Lyczko0/par6-mobile-platform/mobile_base/renders/01_hero.png

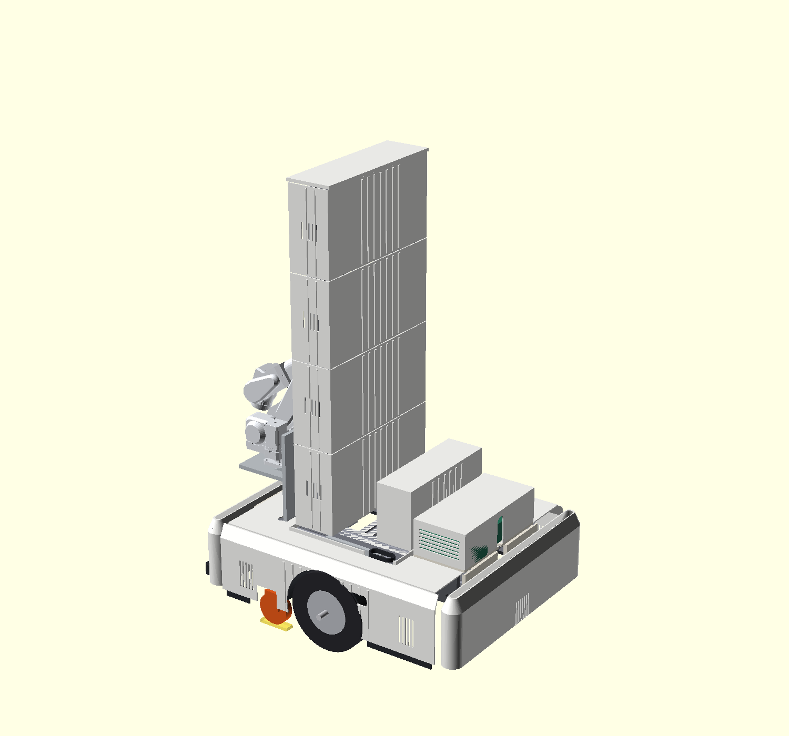
mobile_base/renders/01_hero.png
