Lyczko0/par6-mobile-platform/mobile_base/renders/02_top_bez_oslon.png

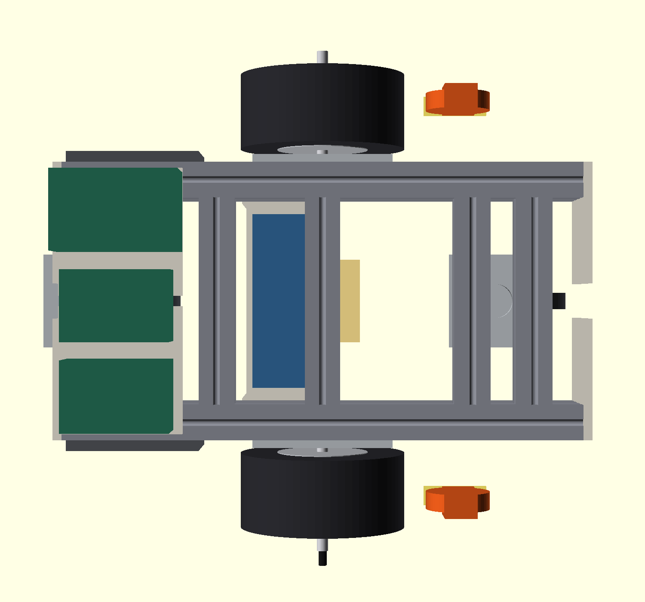
mobile_base/renders/02_top_bez_oslon.png
