Lyczko0/par6-mobile-platform/mobile_base/renders/03_top_z_oslonami.png

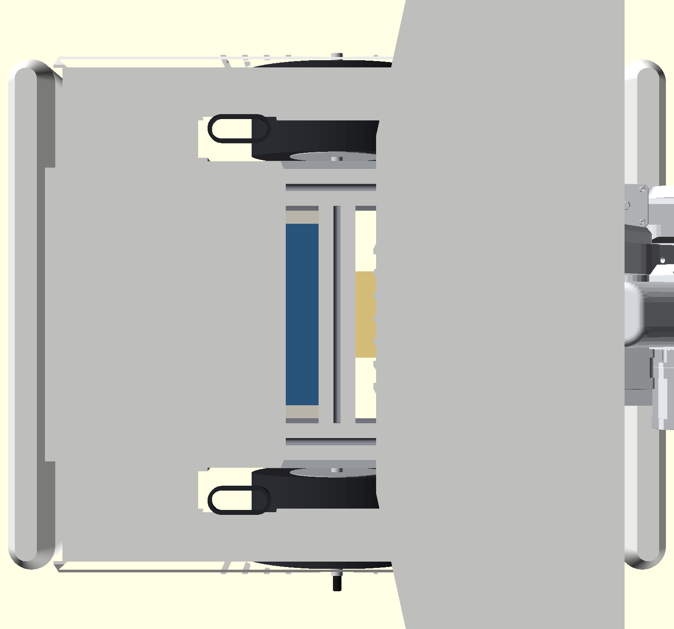
mobile_base/renders/03_top_z_oslonami.png
