Lyczko0/par6-mobile-platform/mobile_base/renders/04_bok_lewy.png

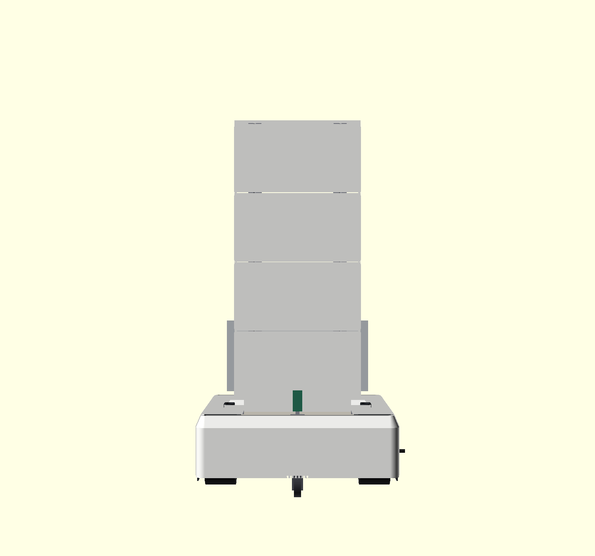
mobile_base/renders/04_bok_lewy.png
