Lyczko0/par6-mobile-platform/mobile_base/renders/06_tyl_serwis.png

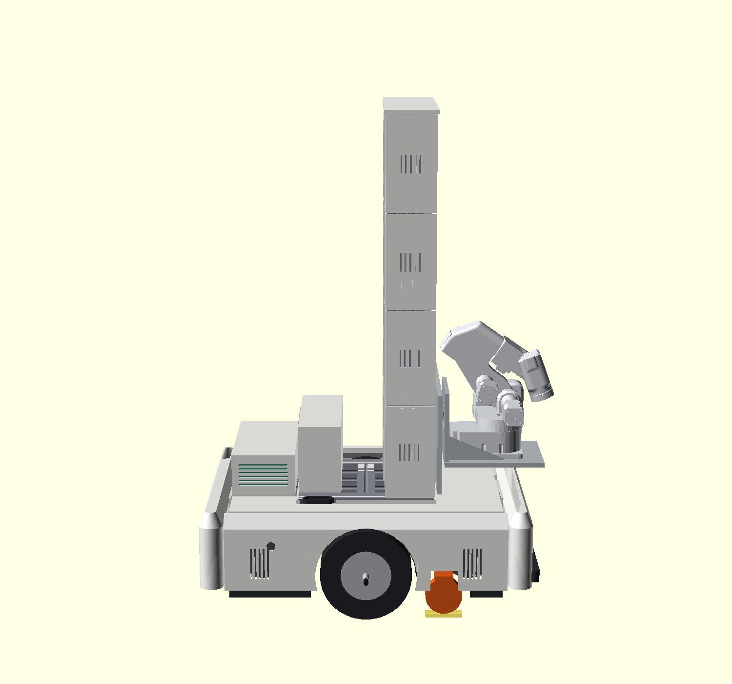
mobile_base/renders/06_tyl_serwis.png
