Lyczko0/par6-mobile-platform/mobile_base/renders/07_spod.png

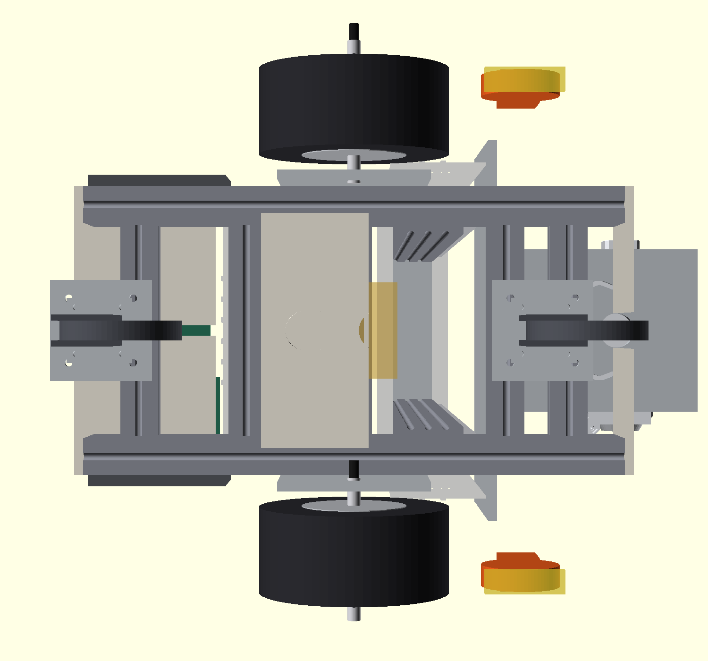
mobile_base/renders/07_spod.png
