Lyczko0/par6-mobile-platform/mobile_base/renders/08_exploded.png

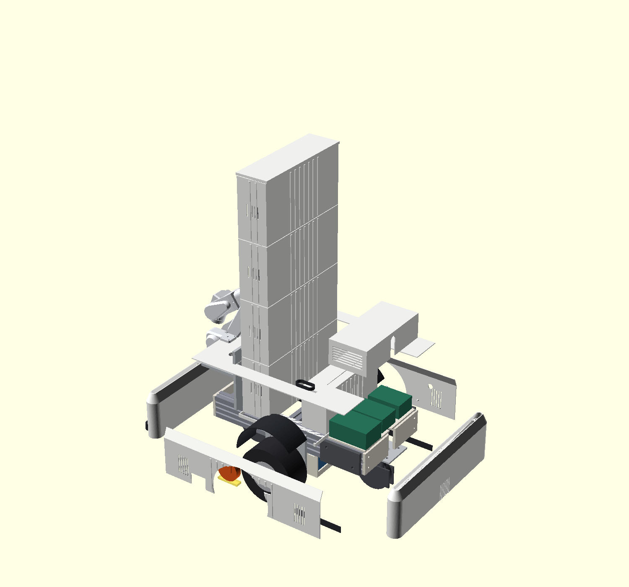
mobile_base/renders/08_exploded.png
