Lyczko0/par6-mobile-platform/mobile_base/renders/13_keepouts.png

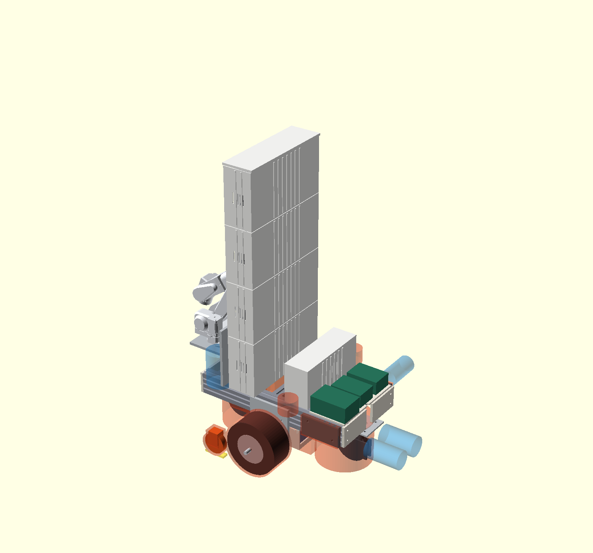
mobile_base/renders/13_keepouts.png
