Lyczko0/par6-mobile-platform/mobile_base/renders/14_par6_real.png

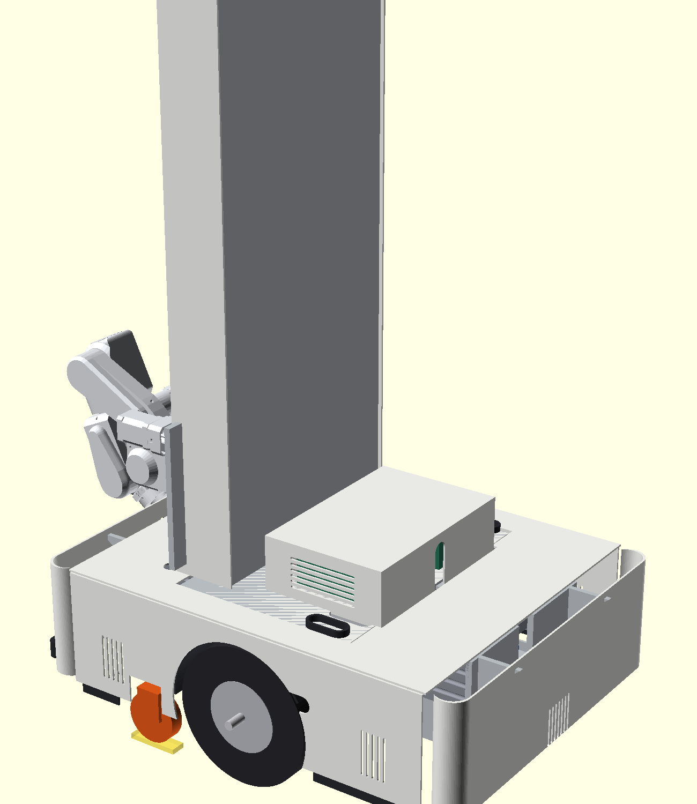
mobile_base/renders/14_par6_real.png
