Lyczko0/par6-mobile-platform/mobile_base/renders/16_par6_low_dwa.png

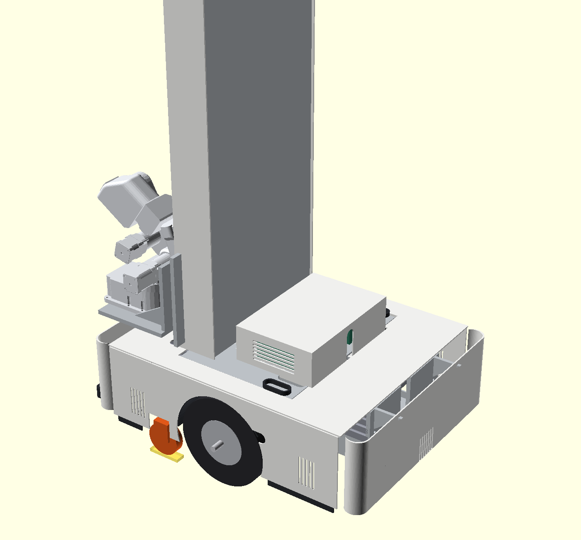
mobile_base/renders/16_par6_low_dwa.png
