Lyczko0/par6-mobile-platform/mobile_base/renders/17_wspornik_detal.png

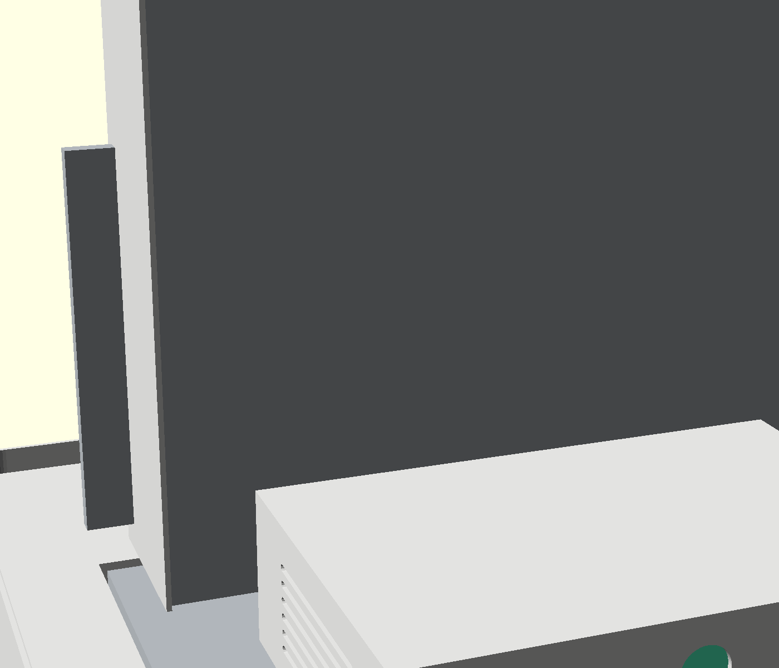
mobile_base/renders/17_wspornik_detal.png
