Lyczko0/par6-mobile-platform/mobile_base/renders/18_wspornik_iso.png

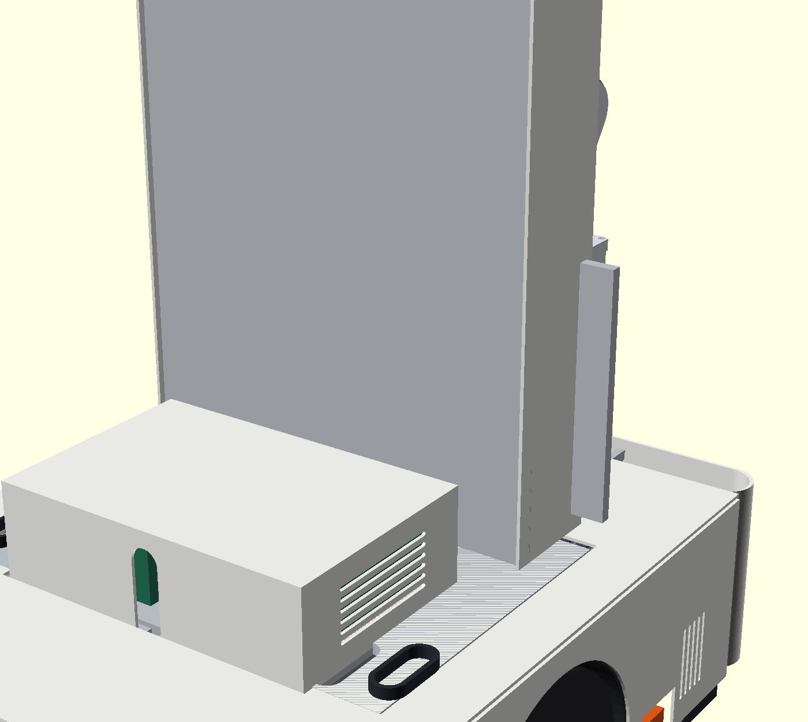
mobile_base/renders/18_wspornik_iso.png
