Lyczko0/par6-mobile-platform/mobile_base/renders/20_gora_kierunek.png

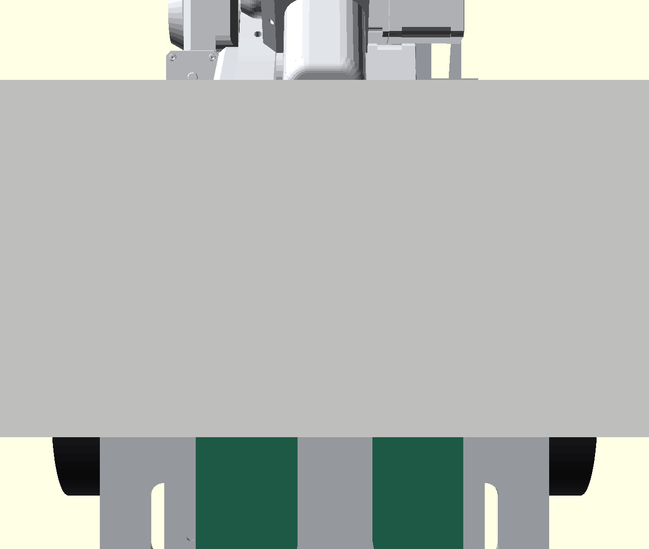
mobile_base/renders/20_gora_kierunek.png
