Lyczko0/par6-mobile-platform/mobile_base/renders/21_hero_bez_oslon.png

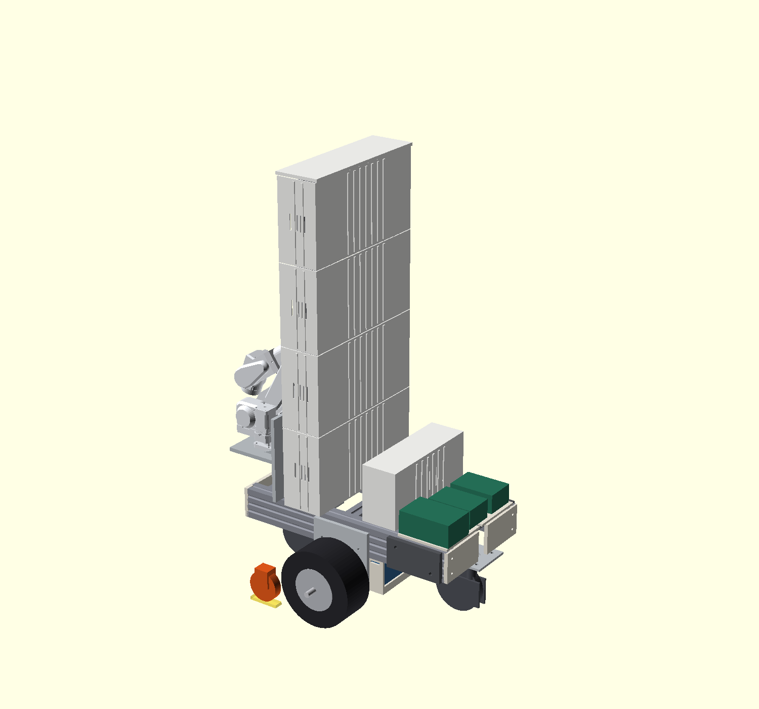
mobile_base/renders/21_hero_bez_oslon.png
