Lyczko0/par6-mobile-platform/mobile_base/renders/24_przod.png

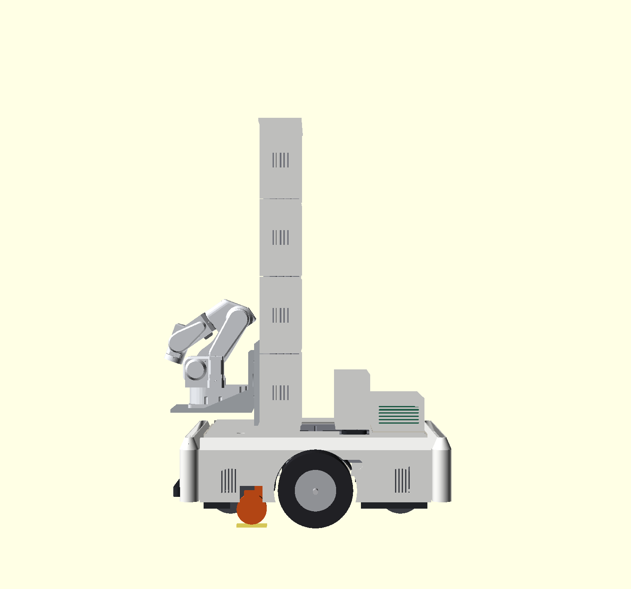
mobile_base/renders/24_przod.png
