Lyczko0/par6-mobile-platform/mobile_base/renders/25_kolumna_detal.png

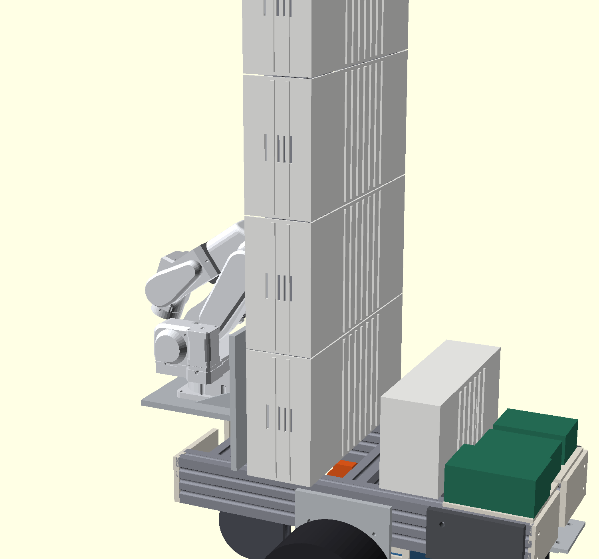
mobile_base/renders/25_kolumna_detal.png
