Lyczko0/par6-mobile-platform/mobile_base/renders/26_tyl_detal.png

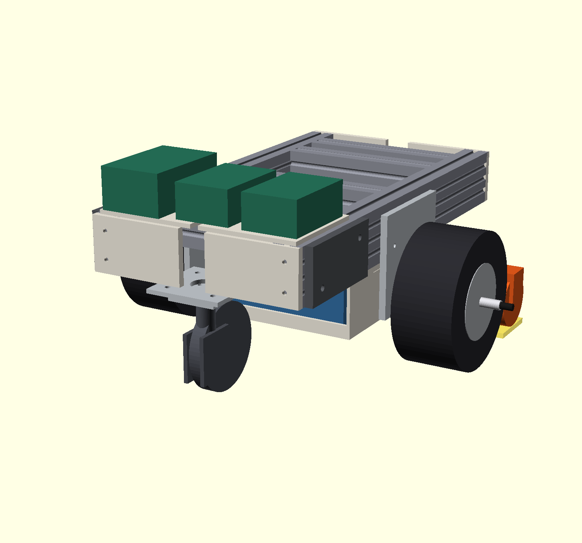
mobile_base/renders/26_tyl_detal.png
