Lyczko0/par6-mobile-platform/mobile_base/renders/dimensions.png

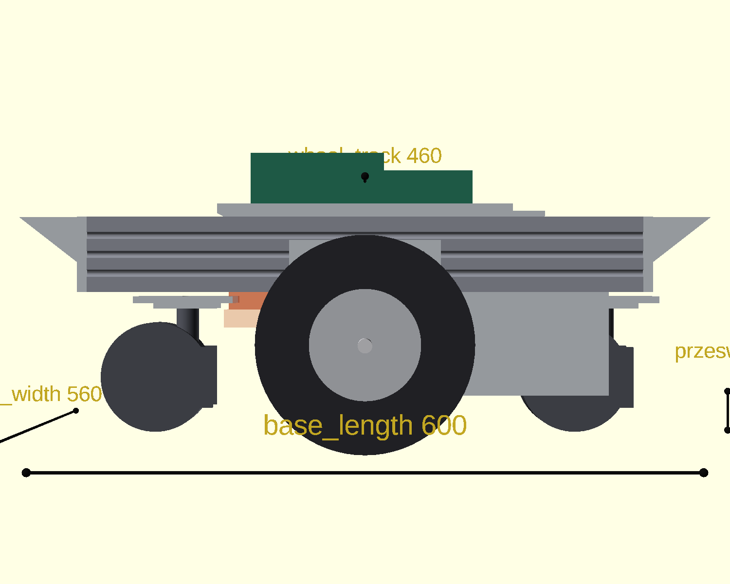
mobile_base/renders/dimensions.png
