Lyczko0/par6-mobile-platform/mobile_base/renders/hero.png

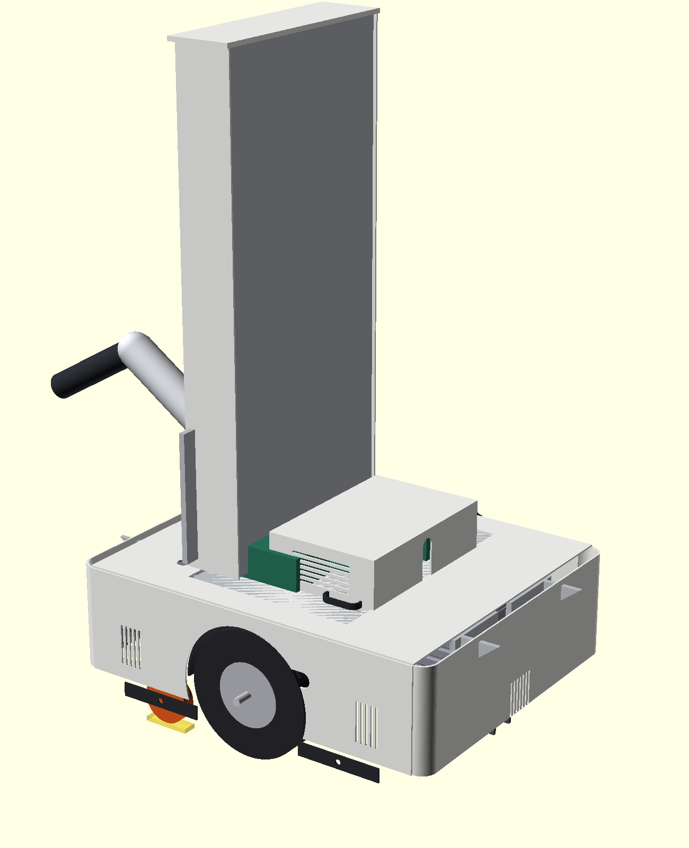
mobile_base/renders/hero.png
