Lyczko0/par6-mobile-platform/mobile_base/renders/recommended_iso.png

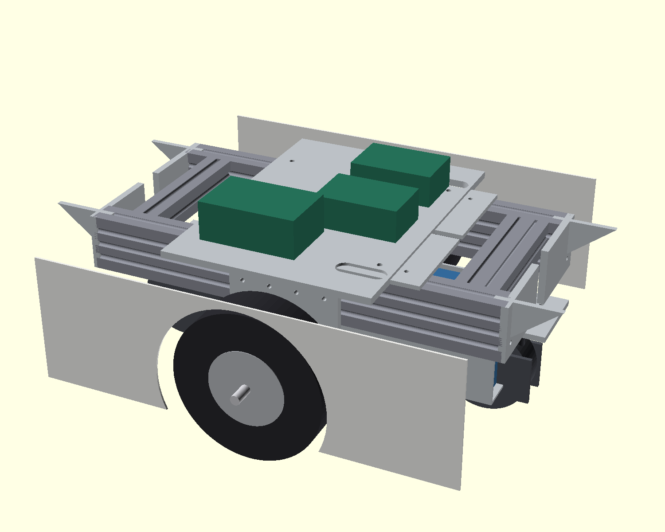
mobile_base/renders/recommended_iso.png
