Lyczko0/par6-mobile-platform/mobile_base/renders/varA_side.png

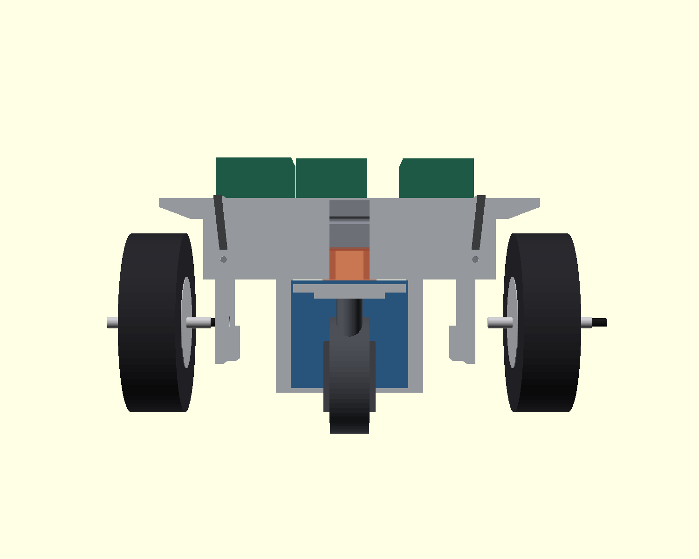
mobile_base/renders/varA_side.png
