Lyczko0/par6-mobile-platform/mobile_base/renders/varA_stab.png

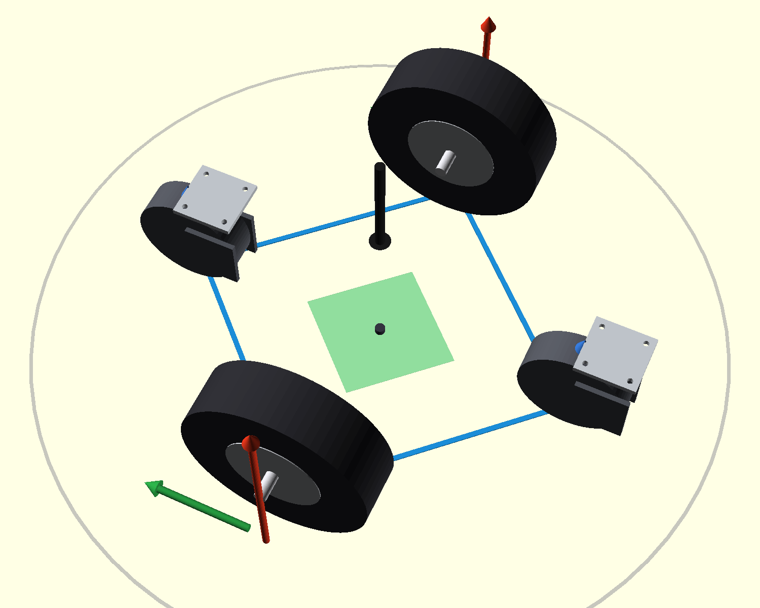
mobile_base/renders/varA_stab.png
