Lyczko0/par6-mobile-platform/mobile_base/renders/varB_iso.png

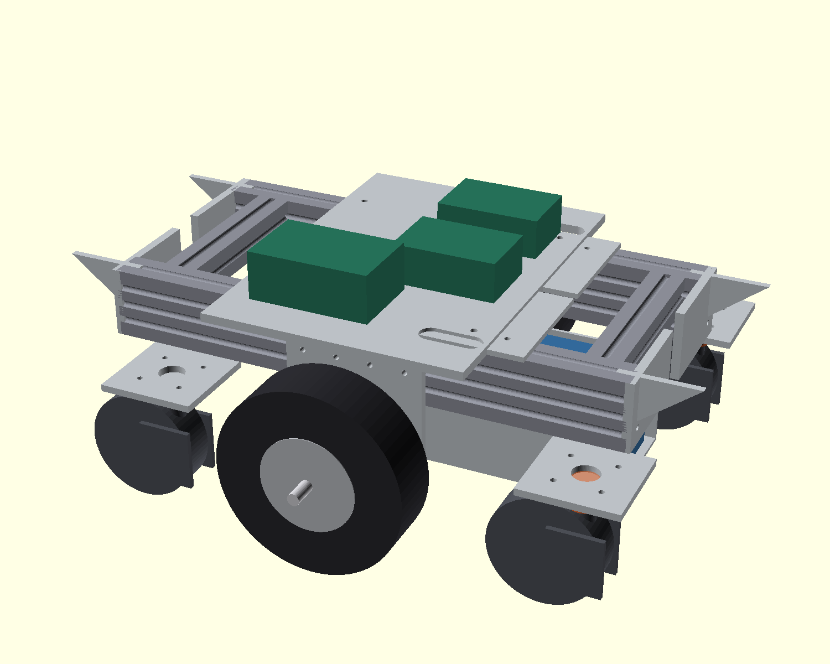
mobile_base/renders/varB_iso.png
