Lyczko0/par6-mobile-platform/mobile_base/renders/varB_top.png

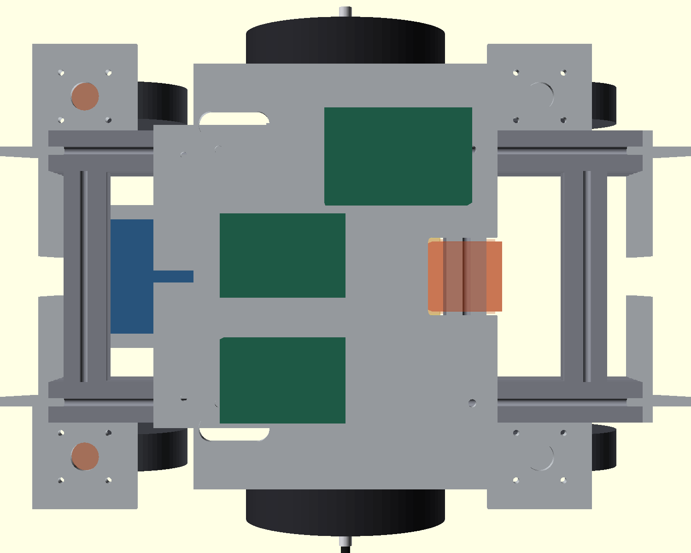
mobile_base/renders/varB_top.png
