Lyczko0/par6-mobile-platform/mobile_base/renders/varC_stab.png

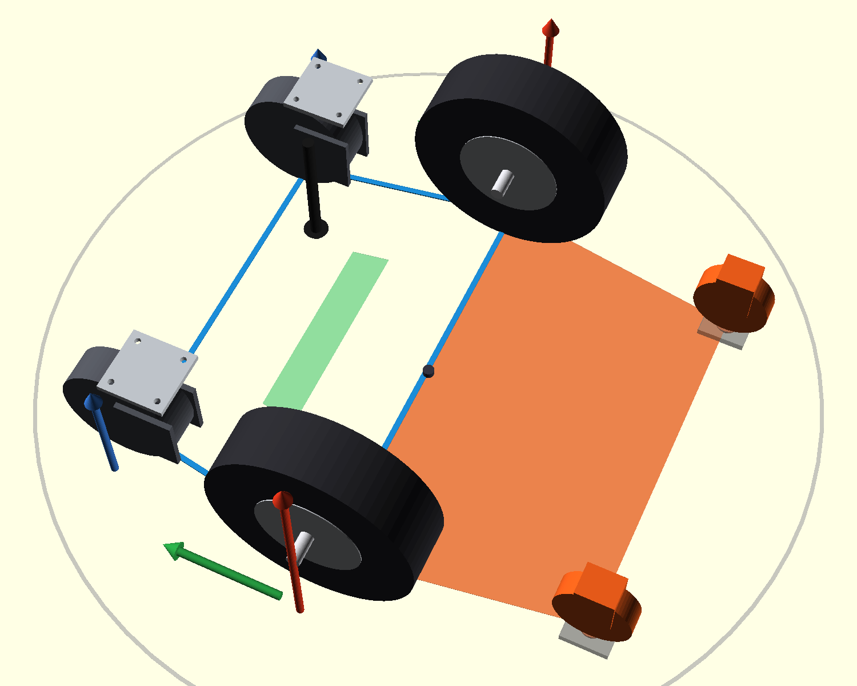
mobile_base/renders/varC_stab.png
