Lyczko0/par6-mobile-platform/z_lift/renders/dimensions.png

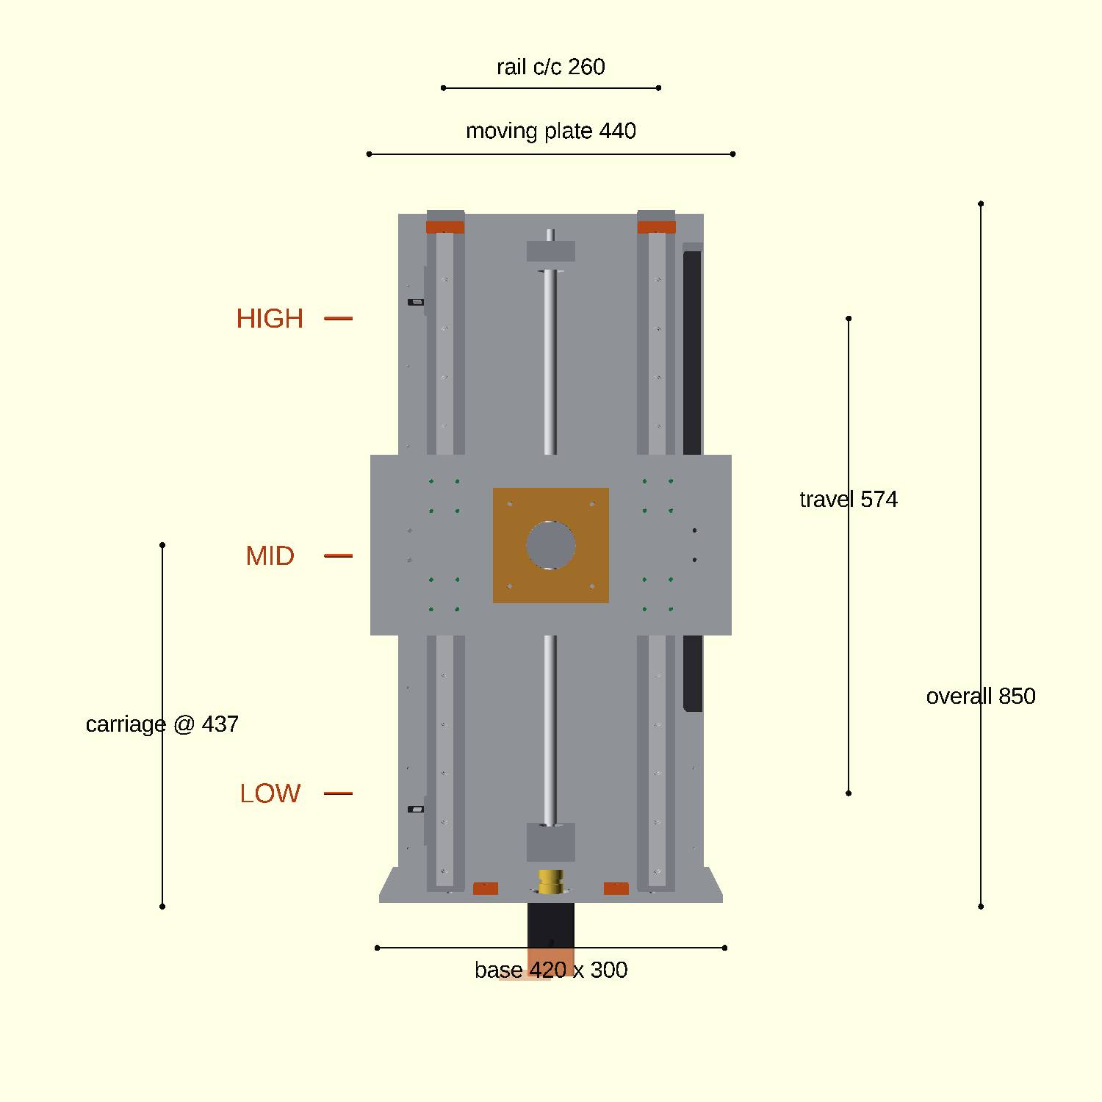
z_lift/renders/dimensions.png
