Lyczko0/par6-mobile-platform/z_lift/renders/dual_arm.png

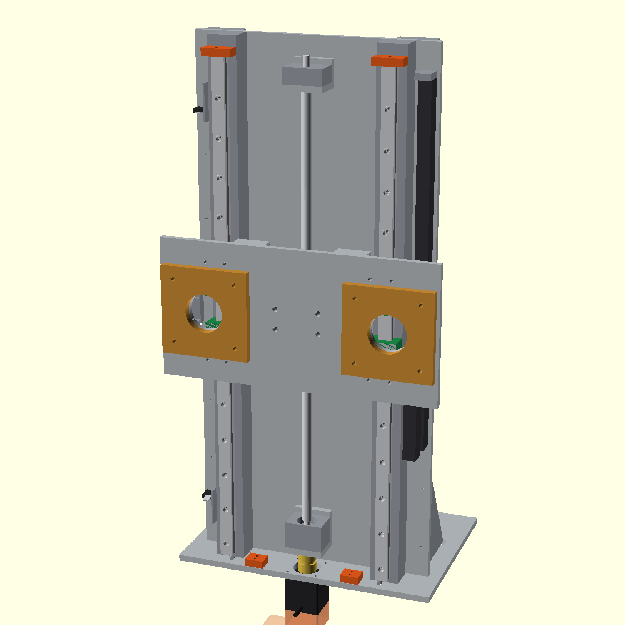
z_lift/renders/dual_arm.png
