Lyczko0/par6-mobile-platform/z_lift/renders/exploded.png

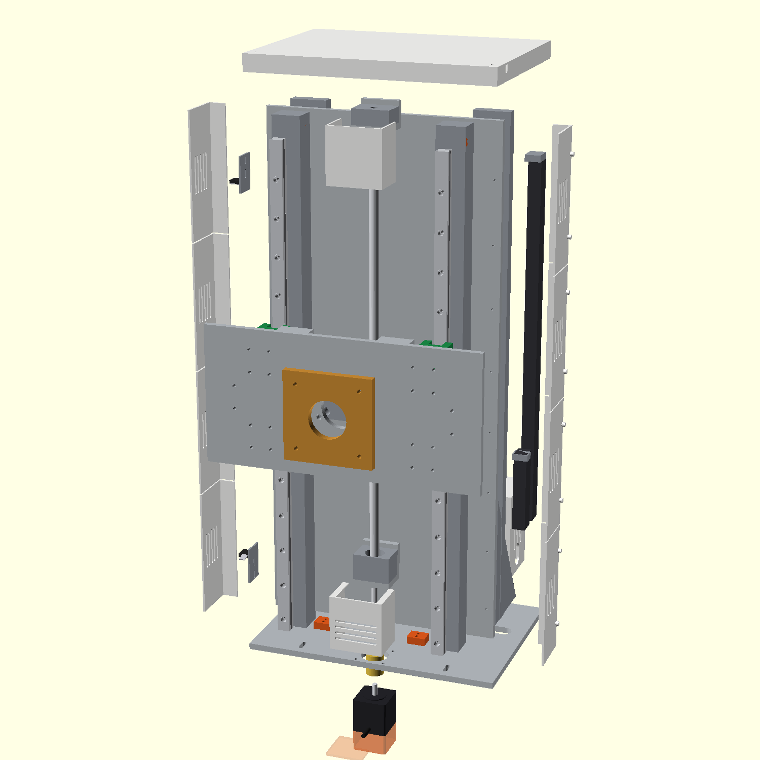
z_lift/renders/exploded.png
