Lyczko0/par6-mobile-platform/z_lift/renders/front.png

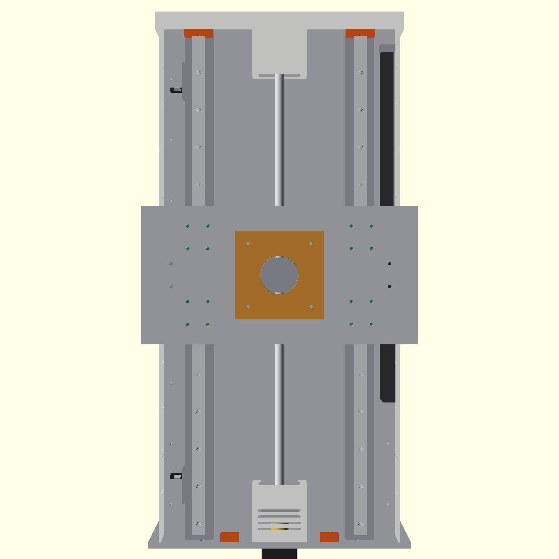
z_lift/renders/front.png
