Lyczko0/par6-mobile-platform/z_lift/renders/motor_bay.png

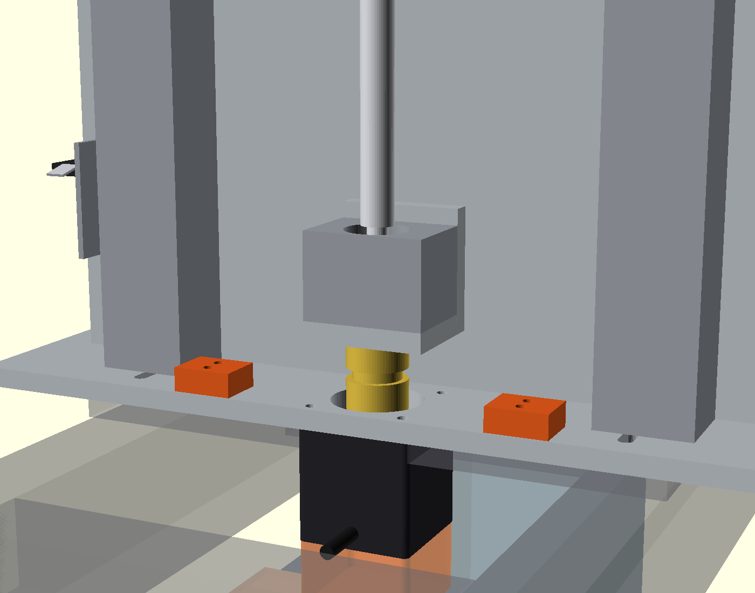
z_lift/renders/motor_bay.png
