Lyczko0/par6-mobile-platform/z_lift/renders/pos_high.png

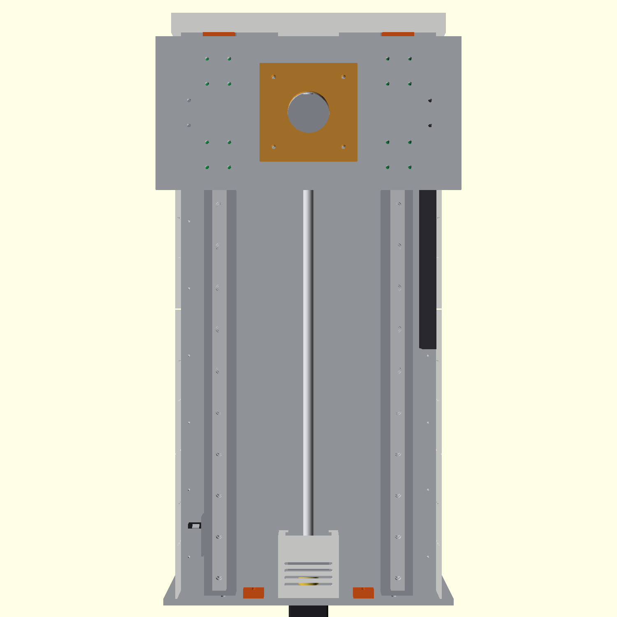
z_lift/renders/pos_high.png
