Lyczko0/par6-mobile-platform/z_lift/renders/side.png

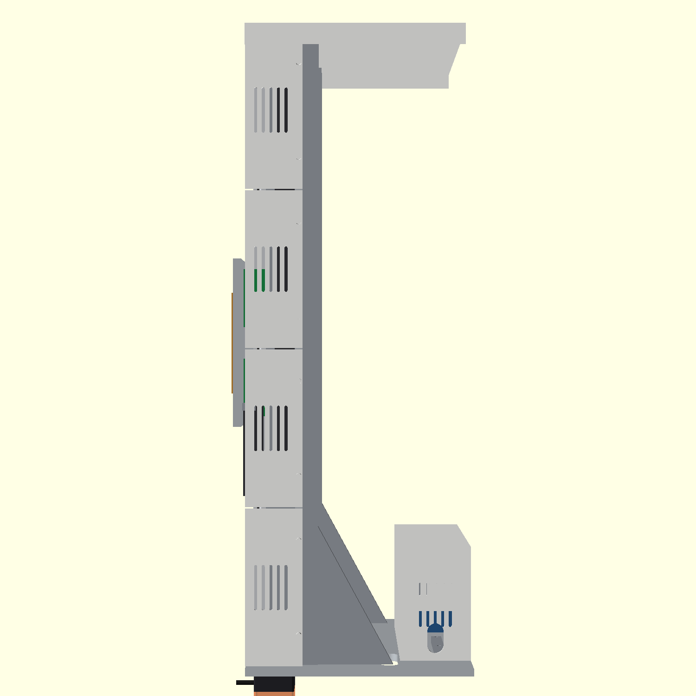
z_lift/renders/side.png
