Lyczko0/par6-mobile-platform/z_lift/components.scad

// ############################################################################
//  components.scad  -  every metal / hardware part of the Z-LIFT
//
//  CONVENTION
//    * Purchased hardware (rail, block, screw, nut, BK12, motor...) is drawn
//      in a LOCAL frame and placed by the caller. Local frames are documented
//      per module.
//    * One-off structural parts (backbone, base plate, risers) are
//      drawn directly in GLOBAL X/Y coordinates, and only their Z is local
//      where the part moves.
//    * Modules that move with the carriage take the plate centre height as
//      their Z origin, so main.scad only has to translate once.
//
//  Everything here is a SIMPLIFIED representation. Bearing internals, seals,
//  ball returns, chamfers and thread forms are not modelled - they do not
//  change the envelope or the interference behaviour.
// ############################################################################

include <parameters.scad>

// ---------------------------------------------------------------------------
//  generic helpers
// ---------------------------------------------------------------------------

// A slotted hole: two circles hulled together. len = total length tip to tip.
module slot(len, d, h) {
    hull() for (s = [-1, 1])
        translate([s*(len - d)/2, 0, 0]) cylinder(d = d, h = h, center = true);
}

// M3 heat-set insert boss for the printed panels.
module m3_boss(h = panel_boss_h) {
    difference() {
        cylinder(d = panel_boss_d, h = h);
        translate([0, 0, -0.5]) cylinder(d = panel_insert_d, h = h);
    }
}

// A row of ventilation slots lying in the XY plane, extruded through +Z.
module vent_row(n, len = vent_len, w = vent_w, pitch = vent_pitch, h = 10) {
    for (i = [0 : n-1])
        translate([0, (i - (n-1)/2) * pitch, -h/2]) slot(len, w, h*2);
}

// ###########################################################################
//  1.  LINEAR MOTION HARDWARE
// ###########################################################################
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
